jamescolb7/Coupe/docs/schematic.pdf

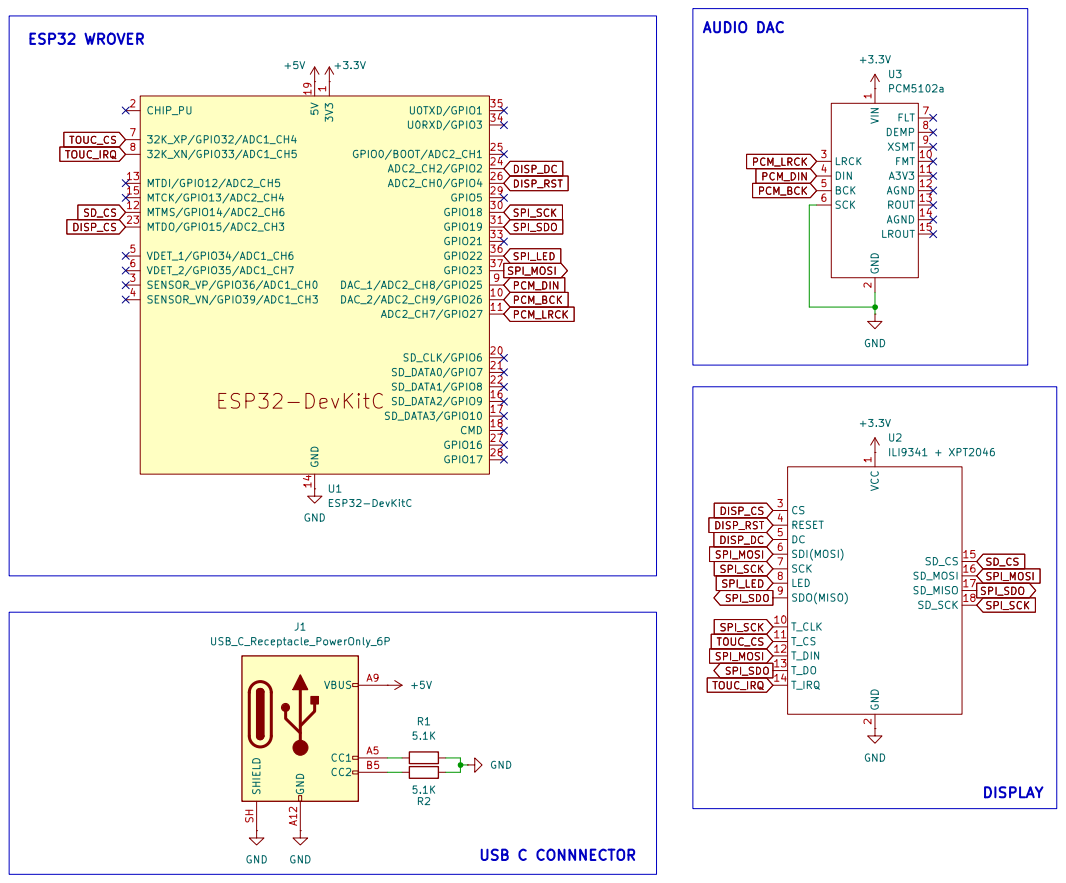
[picture p3: page 1]
