jamescolb7/Coupe/kicad/coupe.kicad_pcb

## KiCad design kicad/coupe.kicad_pcb (2026-08-16)

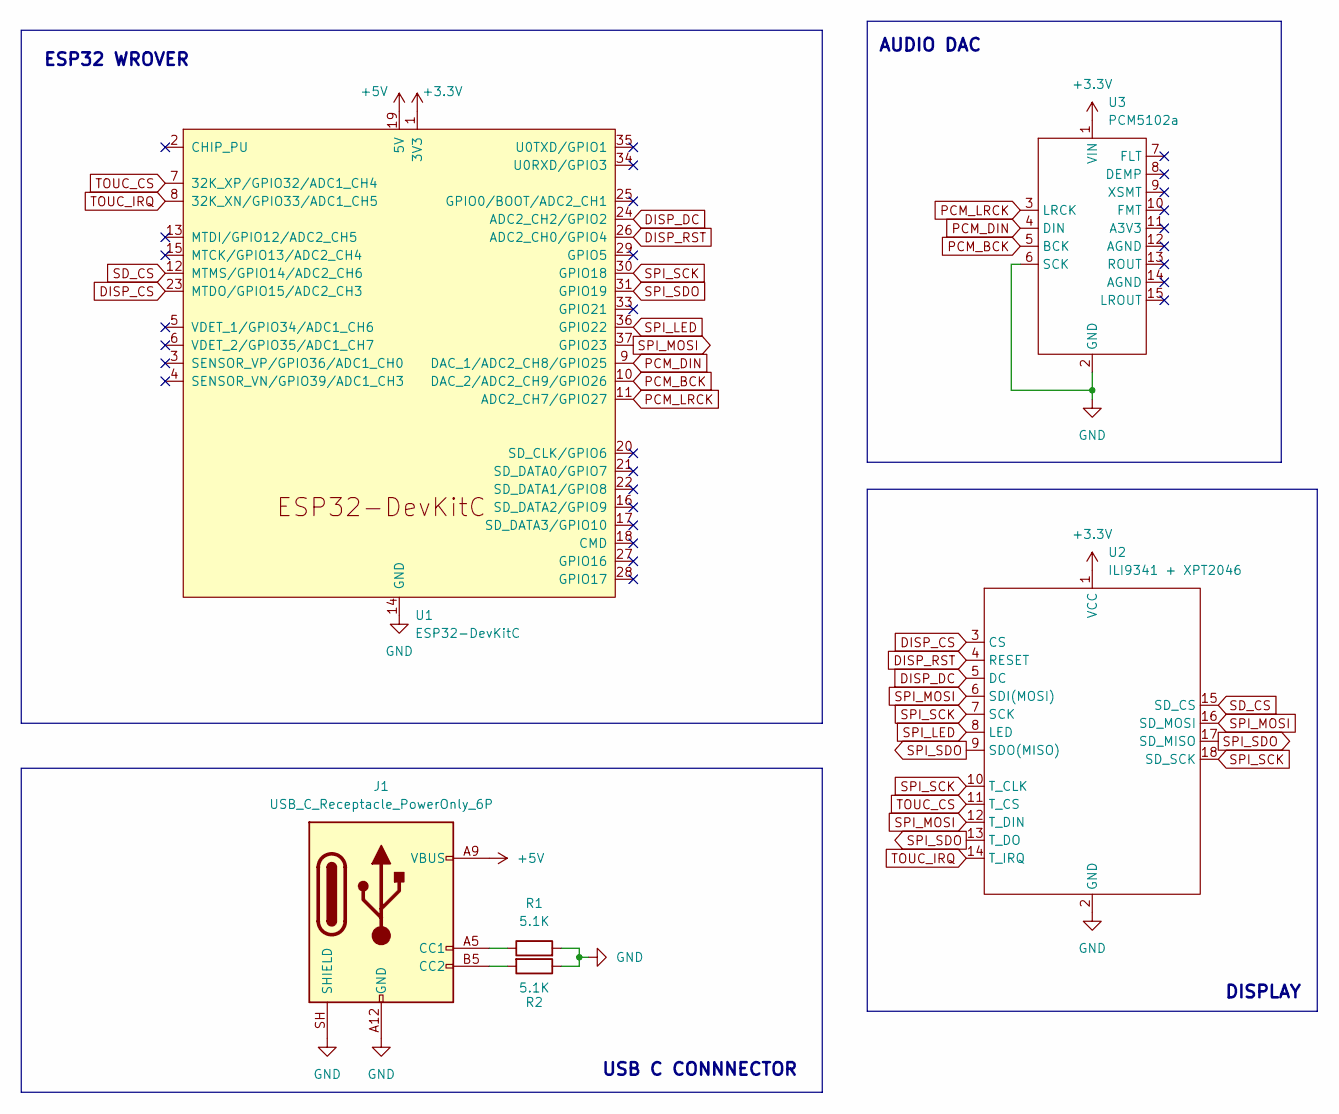
[picture p4: schematic coupe.kicad_sch, Coupe Audio Device]

Parts:
J1: USB_C_Receptacle_PowerOnly_6P; USB-C-SMD_TYPE-602-T3; LCSC Part # C2927028
R1, R2: 5.1K; R0805; LCSC Part # C84375
U1: ESP32-DevKitC
U2: ILI9341 + XPT2046
U3: PCM5102a

Connections:
+3.3V: U1.1 (3V3), U2.1 (VCC), U3.1 (VIN)
+5V: J1.A9 (VBUS), J1.B9 (VBUS), U1.19 (5V)
DISP_CS: U1.23 (MTDO/GPIO15/ADC2_CH3), U2.3 (CS)
DISP_DC: U1.24 (ADC2_CH2/GPIO2), U2.5 (DC)
DISP_RST: U1.26 (ADC2_CH0/GPIO4), U2.4 (RESET)
GND: J1.A12 (GND), J1.B12 (GND), J1.SH (SHIELD), R1.2, R2.1, U1.14 (GND), U1.32 (GND), U1.38 (GND), U2.2 (GND), U3.2 (GND), U3.6 (SCK)
unnamed: J1.A5 (CC1), R1.1
unnamed: J1.B5 (CC2), R2.2
PCM_BCK: U1.10 (DAC_2/ADC2_CH9/GPIO26), U3.5 (BCK)
PCM_DIN: U1.9 (DAC_1/ADC2_CH8/GPIO25), U3.4 (DIN)
PCM_LRCK: U1.11 (ADC2_CH7/GPIO27), U3.3 (LRCK)
SD_CS: U1.12 (MTMS/GPIO14/ADC2_CH6), U2.15 (SD_CS)
SPI_LED: U1.36 (GPIO22), U2.8 (LED)
SPI_MOSI: U1.37 (GPIO23), U2.6 (SDI(MOSI)), U2.12 (T_DIN), U2.16 (SD_MOSI)
SPI_SCK: U1.30 (GPIO18), U2.7 (SCK), U2.10 (T_CLK), U2.18 (SD_SCK)
SPI_SDO: U1.31 (GPIO19), U2.9 (SDO(MISO)), U2.13 (T_DO), U2.17 (SD_MISO)
TOUC_CS: U1.7 (32K_XP/GPIO32/ADC1_CH4), U2.11 (T_CS)
TOUC_IRQ: U1.8 (32K_XN/GPIO33/ADC1_CH5), U2.14 (T_IRQ)

Notes on the sheet:
AUDIO DAC
DISPLAY
ESP32 WROVER
USB C CONNNECTOR

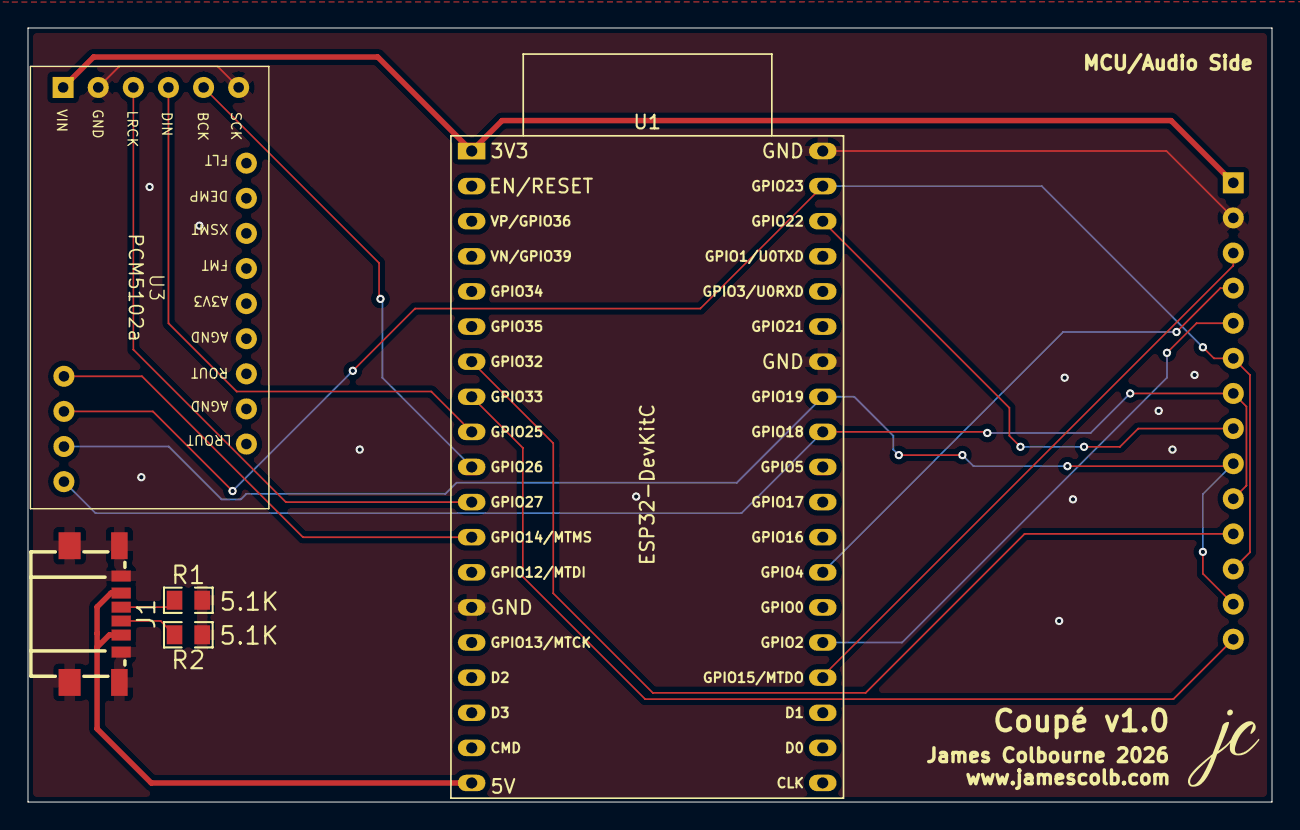
[picture p5: board coupe.kicad_pcb from above]

Board: 4 copper layers, 90.0 x 56.0 mm, 6 parts (1 on the bottom side), 18 nets.
