jamescolb7/Coupe/main/ui/screens/loader.c

#include "esp_lvgl_port.h"

lv_obj_t *ui_Screen2 = NULL;
lv_obj_t *ui_Spinner1 = NULL;
// event funtions

// build funtions

void ui_loader_screen_init(void)
{
    ui_Screen2 = lv_obj_create(NULL);
    lv_obj_clear_flag(ui_Screen2, LV_OBJ_FLAG_SCROLLABLE); /// Flags
    lv_obj_set_style_bg_color(ui_Screen2, lv_color_hex(0x000000), LV_PART_MAIN | LV_STATE_DEFAULT);
    lv_obj_set_style_bg_opa(ui_Screen2, 255, LV_PART_MAIN | LV_STATE_DEFAULT);

    ui_Spinner1 = lv_spinner_create(ui_Screen2);
    lv_obj_set_width(ui_Spinner1, 80);
    lv_obj_set_height(ui_Spinner1, 80);
    lv_obj_set_align(ui_Spinner1, LV_ALIGN_CENTER);
    lv_obj_clear_flag(ui_Spinner1, LV_OBJ_FLAG_CLICKABLE); /// Flags
    lv_obj_set_style_arc_color(ui_Spinner1, lv_color_hex(0x3A3A3A), LV_PART_MAIN | LV_STATE_DEFAULT);
    lv_obj_set_style_arc_opa(ui_Spinner1, 255, LV_PART_MAIN | LV_STATE_DEFAULT);

    lv_obj_set_style_arc_color(ui_Spinner1, lv_color_hex(0xFFFFFF), LV_PART_INDICATOR | LV_STATE_DEFAULT);
    lv_obj_set_style_arc_opa(ui_Spinner1, 255, LV_PART_INDICATOR | LV_STATE_DEFAULT);

    lv_scr_load(ui_Screen2);
}

void ui_loader_screen_destroy(void)
{
    if (ui_Screen2)
        lv_obj_del(ui_Screen2);

    // NULL screen variables
    ui_Screen2 = NULL;
    ui_Spinner1 = NULL;
}
