jamescolb7/Coupe/(commit log)

2026-07-23 Base audio playback and display
    [partitions.csv]
2026-07-31 Global player state, PWM backlight control
2026-08-06 Initial PCB design
    [coupe.csv, coupe.kicad_pcb, coupe.kicad_sch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]
2026-08-06 Board layout improvements
    [coupe.kicad_pcb]
2026-08-16 General PCB layout changes
    [coupe.kicad_pcb]
2026-11-10 UI Stability/Metadata handling improvements
    [lvgl.c, lvgl.h, main.c, ui_sync.c]
2026-11-10 Pause, back, play buttons
